cuihuir/Tiny-M/BOM/BOM.md

**[中文版 / Chinese](BOM_cn.md)**

# Tiny-M Replica BOM

> Based on XiaoChen DIY V2.2, combined with gsl12's original design. Personal replica & optimization version.
>
> Changelog: Based on XiaoChen DIY V2.2, differences from the original are noted.

---

## 1. Aluminum Extrusion

| ID | JLC Model | Spec | Qty | Processing | Notes |
|----|---|---|-----|---|---|
| 300-1 | TXCJ-H7-2020D-L300-SC-DA-LC-Z5-A10-RC-Z5-A60 | 300mm | 2 | Milled face, both-end M5 tap, left M5 hole @10mm, right M5 hole @60mm | Rear pillars |
| 300-2 | TXCJ-H7-2020D-L300-SC-DA-LC-Z5-A10-RC-Z5-A60-RE-Z5-A60 | 300mm | 2 | Milled face, both-end M5 tap, left M5 hole @10mm, right M5 hole @60mm + vertical M5 hole @60mm | Front pillars |
| 250 | TXCJ-H7-2020D-L250-DA-LC-Z5-A10-RC-Z5-A10 | 250mm | 2 | Both-end M5 tap, left M5 hole @10mm, right M5 hole @10mm | Z-axis |
| 260-1 | TXCJ-H7-2020D-L260-DA | 260mm | 2 | Both-end M5 tap | Top left/right |
| 260-2 | TXCJ-H7-2020D-L260-SC-DA-LC-Z5-A36 | 260mm | 2 | Milled face, both-end M5 tap, left M5 hole @36mm | Middle left/right |
| 260-3 | TXCJ-H7-2020D-L260-SC-DA-LC-Z5-A36 | 260mm | 2 | Milled face, both-end M5 tap, left M5 hole @36mm | Bottom left/right |
| 260-4 | TXCJ-H7-2020D-L260-SC-DA | 260mm | 3 | Milled face, both-end M5 tap | Horizontal cross |
| 260-5 | TXCJ-H7-2020D-L260-DA | 260mm | 1 | Both-end M5 tap | X-axis |
| 130-1 | TXCJ-H7-2020D-L130-SC-DA-LC-Z5-A40-RC-Z5-A40 | 130mm | 1 | Milled face, both-end M5 tap, left M5 hole @40mm, right M5 hole @40mm | Heatbed |
| 130-2 | TXCJ-H7-2020D-L130-LA | 130mm | 2 | Left-end M5 tap | Heatbed |

> JLC order file: `BOM/BOM-Frame-JLCFA.xlsx`

## 2. Linear Rails & Carriages

| Item | Spec | Qty | Notes |
|---|---|-----|---|
| MGN9 Rail | 200mm | 2 | Y-axis |
| MGN12 Rail | 200mm | 3 | X-axis x1, Z-axis x2 |
| MGN9H Carriage | - | 2 | Y-axis |
| MGN12H Carriage | **Extended (加长)** | 3 | X-axis x1, Z-axis x2. Must use extended version for E3D V6 hotend mount |

> **Important**: MGN12H carriages must be the **extended/longer version** (加长滑块). Standard MGN12H will not fit the E3D V6 hotend mount. See XiaoChen DIY README: "修改版已适配加长滑块".

### Rail Assembly Jigs (printed)

| File | Purpose |
|---|---|
| `STLs/rail-jigs/mgn12定位件.STL` | MGN12 rail positioning jig |
| `STLs/rail-jigs/mgn9定位件.STL` | MGN9 rail positioning jig |
| `STLs/rail-jigs/导轨滑块防滑脱固定件.stl` | Carriage anti-drop bracket |

## 3. Hotend & Extruder

| Item | Spec | Qty | Notes |
|---|---|-----|---|
| E3D V6 Bowden Hotend | - | 1 | |
| 4010 Blower Fan | - | 2 | |
| 4020 Cooling Fan | - | 1 | |
| BMG Dual Gear Extruder | - | 1 | |
| GT2 Belt | 6mm width | 4m | |

## 4. Endstops

| Item | Spec | Qty | Notes |
|---|---|-----|---|
| XY Mechanical Endstop | - | 2 | |
| Z Optical Endstop | - | 1 | XiaoChen DIY mod |

## 5. Stepper Motors

| Item | Spec | Qty | Notes |
|---|---|-----|---|
| XY Motor | 42x47 NEMA 17 | 2 | |
| Z Motor | NEMA 17 | 1 | |
| Extruder Motor | NEMA 17 | 1 | |
| GT2 20T Pulley | 5mm bore | 3 | Mounted on motors |
| AB Motor Pulley Spacer | ID5 OD10 H9 | 2 | Metal part or printed |

## 6. Heatbed

| Item | Spec | Qty | Notes |
|---|---|-----|---|
| T8 Lead Screw | 220mm | 1 | |
| Spider Coupler | OD25 H30 5-to-8 | 1 | Or standard 5-to-8 coupler |
| T8 Anti-backlash Nut | POM, no flange ridge | 1 | |
| Custom Aluminum Plate | 150x150x8mm | 1 | DXF: `DXFs/heatbed-aluminum-plate-v1.1.DXF`. Countersunk holes depth 2–3.5mm. Source: XiaoChen DIY V1.1 |
| Magnetic PEI Steel Sheet | 150x150mm | 1 | |
| Silicone Heater Pad | 220V 110W | 1 | |
| Solid State Relay | DC-AC | 1 | |
| Thermal Fuse | RH 250V 15A 125C | 1 | |
| Drag Chain | 10x10 bridge type | 1m | Open or closed |
| Leveling Spring | OD10 H25 | 3 | |
| Flat Head M3x30 Screw | - | 3 | Paired with springs & thumbscrews |
| Thumbscrew Nut | - | 3 | |

## 7. Electronics

| Item | Spec | Qty | Notes |
|---|---|-----|---|
| Controller Board | MKS Robin E3D | 1 | |
| SBC | Orange Pi Zero2 | 1 | |
| SD Card | 16GB | 1 | |
| SD Card Reader | - | 1 | |
| LCD Display | Mini 12864 | 1 | |
| Stepper Driver | TMC2209 | 4 | |
| Power Supply | 24V 250W | 1 | |
| Buck Converter | 24V to 5V | 1 | For Orange Pi |
| Rocker Switch | With power | 1 | |
| Power-off Relay | 1-ch 5V optocoupled | 1 | |

## 8. Screws Summary

| Type | Qty | Notes |
|---|-----|---|
| SHCS M2x12 | 5 | |
| SHCS M3x8 | 81 | |
| SHCS M3x10 | 13 | |
| SHCS M3x12 | 8 | |
| SHCS M3x16 | 1 | |
| SHCS M3x20 | 4 | |
| SHCS M3x25 | 4 | |
| SHCS M3x30 | 6 | |
| SHCS M3x35 | 16 | |
| SHCS M3x45 | 2 | |
| SHCS M3x50 | 2 | |
| SHCS M5x8 | 6 | |
| SHCS M5x10 | 8 | |
| SHCS M5x14 | 2 | |
| SHCS M5x16 | 2 | |
| SHCS M5x40 | 4 | |
| BHCS M3x6 | 1 | Direct drive only |
| BHCS M3x8 | 4 | |
| BHCS M3x12 | 1 | Direct drive only |
| BHCS M3x14 | 2 | Direct drive only |
| BHCS M3x20 | 2 | |
| BHCS M3x25 | 1 | Direct drive only |
| BHCS M5x6 | 4 | |
| BHCS M5x8 | 5 | |
| BHCS M5x10 | 35 | |
| BHCS M5x12 | 2 | |
| BHCS M5x14 | 6 | |
| BHCS M5x16 | 2 | |
| BHCS M5x20 | 1 | |
| BHCS M5x30 | 4 | |
| BHCS M5x35 | 4 | |

## 9. Nuts Summary

| Type | Qty | Notes |
|---|-----|---|
| M3 Spring Nut | 25 | |
| M3 Sliding Nut | 37 | Prepare 28 more for rails |
| M3x4x5 Heatset Insert | 22 | |
| M3 Hex Nut | 15 | |
| M5 Spring Nut | 16 | |
| M5 Sliding Nut | 31 | |

## 10. Bearings & Washers

| Type | Qty | Notes |
|---|-----|---|
| F695-2RS Flange Bearing (5mm) | 20 | |
| GT2 20T Toothed Idler (6mm belt) | 2 | |
| Washer 5x10x1mm | 22 | |
| Washer 5x10x0.5mm | 2 | |

## 11. Misc

| Item | Spec | Qty | Notes |
|---|---|-----|---|
| Rubber Feet | H12, OD18 | 4 | |
| Voron 0/0.1 Belt Clip | Rectangle | 2 | |
