cuihuir/Tiny-M/BOM/BOM_cn.md

**[English](BOM.md)**

# Tiny-M 复刻版 BOM

> 基于小辰DIY V2.2 版本，结合 gsl12 原版方案，个人复刻优化版
>
> 修改记录：以小辰DIY V2.2 为基础，标注与原版的差异

---

## 1. 型材

| 编号 | JLC 型号 | 规格 | 数量 | 加工内容 | 备注 |
|---|---|---|---|---|---|
| 300-1 | TXCJ-H7-2020D-L300-SC-DA-LC-Z5-A10-RC-Z5-A60 | 300mm | 2 | 铣端面、双端攻牙M5、左端水平沉头M5@10mm、右端水平沉头M5@60mm | 后立柱 |
| 300-2 | TXCJ-H7-2020D-L300-SC-DA-LC-Z5-A10-RC-Z5-A60-RE-Z5-A60 | 300mm | 2 | 铣端面、双端攻牙M5、左端水平沉头M5@10mm、右端水平+垂直沉头M5@60mm | 前立柱 |
| 250 | TXCJ-H7-2020D-L250-DA-LC-Z5-A10-RC-Z5-A10 | 250mm | 2 | 双端攻牙M5、左端水平沉头M5@10mm、右端水平沉头M5@10mm | Z 轴 |
| 260-1 | TXCJ-H7-2020D-L260-DA | 260mm | 2 | 双端攻牙M5 | 上方左右 |
| 260-2 | TXCJ-H7-2020D-L260-SC-DA-LC-Z5-A36 | 260mm | 2 | 铣端面、双端攻牙M5、左端水平沉头M5@36mm | 中间左右 |
| 260-3 | TXCJ-H7-2020D-L260-SC-DA-LC-Z5-A36 | 260mm | 2 | 铣端面、双端攻牙M5、左端水平沉头M5@36mm | 下方左右 |
| 260-4 | TXCJ-H7-2020D-L260-SC-DA | 260mm | 3 | 铣端面、双端攻牙M5 | 中间横 |
| 260-5 | TXCJ-H7-2020D-L260-DA | 260mm | 1 | 双端攻牙M5 | X 轴 |
| 130-1 | TXCJ-H7-2020D-L130-SC-DA-LC-Z5-A40-RC-Z5-A40 | 130mm | 1 | 铣端面、双端攻牙M5、左端水平沉头M5@40mm、右端水平沉头M5@40mm | 热床 |
| 130-2 | TXCJ-H7-2020D-L130-LA | 130mm | 2 | 左端攻牙M5 | 热床 |

> 嘉立创下单文件：`BOM/BOM-Frame-JLCFA.xlsx`

## 2. 导轨与滑块

| 名称 | 规格 | 数量 | 备注 |
|---|---|---|---|
| MGN9 导轨 | 200mm | 2 | Y 方向 |
| MGN12 导轨 | 200mm | 3 | X×1、Z×2 |
| MGN9H 滑块 | - | 2 | Y 方向 |
| MGN12H 滑块 | **加长版** | 3 | X×1、Z×2。必须使用加长滑块，标准滑块无法适配 E3D V6 热端固定座 |

> **重要**：MGN12H 滑块必须是**加长版本**。标准 MGN12H 无法安装 E3D V6 热端固定座。参考小辰DIY说明："修改版已适配加长滑块"。

### 导轨辅助打印件

| 文件 | 用途 |
|---|---|
| `STLs/rail-jigs/mgn12定位件.STL` | MGN12 导轨定位件 |
| `STLs/rail-jigs/mgn9定位件.STL` | MGN9 导轨定位件 |
| `STLs/rail-jigs/导轨滑块防滑脱固定件.stl` | 滑块防滑脱固定件 |

## 3. 热端与挤出

| 名称 | 规格 | 数量 | 备注 |
|---|---|---|---|
| E3D V6 远程挤出头 | - | 1 | |
| 4010 涡轮风扇 | - | 2 | |
| 4020 散热风扇 | - | 1 | |
| BMG 双齿轮减速挤出机 | - | 1 | |
| 2GT 同步带 | 6mm 宽 | 4m | |

## 4. 限位开关

| 名称 | 规格 | 数量 | 备注 |
|---|---|---|---|
| XY 机械限位开关 | - | 2 | |
| Z 光电限位 | - | 1 | 小辰DIY 修改方案 |

## 5. 电机

| 名称 | 规格 | 数量 | 备注 |
|---|---|---|---|
| XY 步进电机 | 42×47 NEMA 17 | 2 | |
| Z 步进电机 | NEMA 17 | 1 | |
| 挤出机电机 | NEMA 17 | 1 | |
| 2GT 20 齿同步轮 | 5mm 孔径 | 3 | 固定在电机上 |
| AB 电机同步轮格挡柱 | 内5 外10 高9 | 2 | 金属件或打印替代 |

## 6. 热床

| 名称 | 规格 | 数量 | 备注 |
|---|---|---|---|
| T8 丝杆 | 220mm | 1 | |
| 梅花联轴器 | 外25 高30 内5转8 | 1 | 或普通 5 转 8 |
| T8 消隙螺母 | POM 法兰盘无凸环 | 1 | |
| 定制铝板 | 150×150×8mm | 1 | 加工图：`DXFs/heatbed-aluminum-plate-v1.1.DXF`，沉头孔深度 2–3.5mm，来源：小辰DIY V1.1 |
| 磁性 PEI 钢板 | 150×150mm | 1 | |
| 硅胶加热垫 | 220V 110W | 1 | |
| 固态继电器 | DC-AC | 1 | |
| 热熔保险丝 | RH 250V 15A 125° | 1 | |
| 拖链 | 10×10 桥式 | 1m | 不开或外开均可 |
| 调节弹簧 | 外径10 高25 | 3 | |
| 平头 M3×30 螺丝 | - | 3 | 与弹簧手拧螺母配套 |
| 手拧螺母 | - | 3 | |

## 7. 电气

| 名称 | 规格 | 数量 | 备注 |
|---|---|---|---|
| 主板 | MKS Robin E3D | 1 | |
| 上位机 | 香橙派 Zero2 | 1 | |
| SD 卡 | 16G | 1 | |
| SD 卡读卡器 | - | 1 | |
| LCD 屏幕 | Mini 12864 | 1 | |
| 步进电机驱动 | TMC2209 | 4 | |
| 电源 | 24V 250W | 1 | |
| 降压模块 | 24V→5V | 1 | 给香橙派供电 |
| 电源船型开关 | - | 1 | 带电源 |
| 打完关机继电器 | 一路 5V 光电耦合 | 1 | |

## 8. 螺丝汇总

| 型号 | 数量 | 备注 |
|---|---|---|
| 杯头 M2×12 | 5 | |
| 杯头 M3×8 | 81 | |
| 杯头 M3×10 | 13 | |
| 杯头 M3×12 | 8 | |
| 杯头 M3×16 | 1 | |
| 杯头 M3×20 | 4 | |
| 杯头 M3×25 | 4 | |
| 杯头 M3×30 | 6 | |
| 杯头 M3×35 | 16 | |
| 杯头 M3×45 | 2 | |
| 杯头 M3×50 | 2 | |
| 杯头 M5×8 | 6 | |
| 杯头 M5×10 | 8 | |
| 杯头 M5×14 | 2 | |
| 杯头 M5×16 | 2 | |
| 杯头 M5×40 | 4 | |
| 半圆头 M3×6 | 1 | 近程挤出 |
| 半圆头 M3×8 | 4 | |
| 半圆头 M3×12 | 1 | 近程挤出 |
| 半圆头 M3×14 | 2 | 近程挤出 |
| 半圆头 M3×20 | 2 | |
| 半圆头 M3×25 | 1 | 近程挤出 |
| 半圆头 M5×6 | 4 | |
| 半圆头 M5×8 | 5 | |
| 半圆头 M5×10 | 35 | |
| 半圆头 M5×12 | 2 | |
| 半圆头 M5×14 | 6 | |
| 半圆头 M5×16 | 2 | |
| 半圆头 M5×20 | 1 | |
| 半圆头 M5×30 | 4 | |
| 半圆头 M5×35 | 4 | |

## 9. 螺母汇总

| 型号 | 数量 | 备注 |
|---|---|---|
| M3 弹珠螺母 | 25 | |
| M3 滑块螺母 | 37 | 额外准备 28 个用于导轨 |
| 热熔螺母 M3×4×5 | 22 | |
| M3 六角螺母 | 15 | |
| M5 弹珠螺母 | 16 | |
| M5 滑块螺母 | 31 | |

## 10. 轴承与垫片

| 型号 | 数量 | 备注 |
|---|---|---|
| F695-2RS 法兰轴承 (5mm) | 20 | |
| 2GT 20 齿惰轮（带宽 6mm） | 2 | |
| 垫片 5×10×1mm | 22 | |
| 垫片 5×10×0.5mm | 2 | |

## 11. 其他

| 名称 | 规格 | 数量 | 备注 |
|---|---|---|---|
| 脚垫 | 高12 大头直径18 | 4 | |
| Voron 0/0.1 同步带固定长方形 | - | 2 | |
