cuihuir/Tiny-M/BOM/BOM-Frame-JLCFA.md

# 嘉立创FA BOM - Frame (首版已下单)

> 来源：jialichuangtrs.xlsx，JLC 可直接下单型号

| 序号 | *我的型号 | 我的商品名称 | JLC型号（如有，则请填写） | *商品数量 | 是否国产替代 | 品牌 | 类别 | PO号 |
|---|---|---|---|---|---|---|---|---|
| 1 | 300-1 | 2020铝型材 300mm 后立柱 | TXCJ-H7-2020D-L300-SC-DA-LC-Z5-A10-RC-Z5-A60 | 2 | 是 | TXCJ | 铝型材 | |
| 2 | 300-2 | 2020铝型材 300mm 前立柱 | TXCJ-H7-2020D-L300-SC-DA-LC-Z5-A10-RC-Z5-A60-RE-Z5-A60 | 2 | 是 | TXCJ | 铝型材 | |
| 3 | 250 | 2020铝型材 250mm Z轴 | TXCJ-H7-2020D-L250-DA-LC-Z5-A10-RC-Z5-A10 | 2 | 是 | TXCJ | 铝型材 | |
| 4 | 260-1 | 2020铝型材 260mm 上方左右 | TXCJ-H7-2020D-L260-DA | 2 | 是 | TXCJ | 铝型材 | |
| 5 | 260-2 | 2020铝型材 260mm 中间左右 | TXCJ-H7-2020D-L260-SC-DA-LC-Z5-A36 | 2 | 是 | TXCJ | 铝型材 | |
| 6 | 260-3 | 2020铝型材 260mm 下方左右 | TXCJ-H7-2020D-L260-SC-DA-LC-Z5-A36 | 2 | 是 | TXCJ | 铝型材 | |
| 7 | 260-4 | 2020铝型材 260mm 中间横 | TXCJ-H7-2020D-L260-SC-DA | 3 | 是 | TXCJ | 铝型材 | |
| 8 | 260-5 | 2020铝型材 260mm X轴 | TXCJ-H7-2020D-L260-DA | 1 | 是 | TXCJ | 铝型材 | |
| 9 | 130-1 | 2020铝型材 130mm 热床(打孔40) | TXCJ-H7-2020D-L130-SC-DA-LC-Z5-A40-RC-Z5-A40 | 1 | 是 | TXCJ | 铝型材 | |
| 10 | 130-2 | 2020铝型材 130mm 热床 | TXCJ-H7-2020D-L130-LA | 2 | 是 | TXCJ | 铝型材 | |
