cuihuir/Tiny-M/BOM/reference/DRAFT-BOM-gsl12.md

**[中文版 / Chinese](DRAFT-BOM-gsl12_cn.md)**

# Tiny-M Draft BOM (gsl12 Original)

> Source: [gsl12/Tiny-M](https://github.com/gsl12/Tiny-M) original repository
>
> Status: DRAFT, published by original author gsl12

---

## Hardware

| Component | Standard | Qty | Notes |
|---|---|-----|---|
| 5x10x0.5 Shim Ring | DIN 988 5x10x0.5 | 17 | |
| 5x10x1 Shim Ring | DIN 988 5x10x1 | 6 | |
| 5x30mm Shaft | shaft 5x30mm | 1 | |
| M2.5x12 SHCS (dragon hotend only) | DIN 912 M2.5x12 | 4 | |
| M2x10 Self Tapping Screw for Plastic | - | 15 | |
| M3 T-Nut | M3 T-Nut | 6 | |
| M3 Brass Heatstake Inserts | M3x5.0x4.0 | 15 | |
| M3 Nut | DIN 934 M3 Nut | 14 | |
| M3x10 SHCS | DIN 912 M3x10 | 2 | |
| M3x12 SHCS | DIN 912 M3x12 | 2 | |
| M3x20 SHCS | DIN 912 M3x20 | 2 | |
| M3x25 SHCS | DIN 912 M3x25 | 2 | |
| M3x30 SHCS | DIN 912 M3x30 | 8 | |
| M3x35 SHCS | DIN 912 M3x35 | 8 | |
| M3x40 SHCS | DIN 912 M3x40 | 12 | |
| M3x50 SHCS | DIN 912 M3x50 | 4 | |
| M3x8 SHCS | DIN 912 M3x8 | 99 | |
| M4x8 SHCS | DIN 912 M4x8 | 4 | |
| M5 T-Nut | M5 T-Nut | 18 | |
| M5x10 BHCS | ISO 7380-1 M5x10 | 19 | |
| M5x15 BHCS | ISO 7380-1 M5x15 | 1 | |
| M5x16 BHCS | ISO 7380-1 M5x16 | 4 | |
| M5x20 BHCS | ISO 7380-1 M5x20 | 1 | |
| M5x30 BHCS | ISO 7380-1 M5x30 | 4 | |
| M5x35 BHCS | ISO 7380-1 M5x35 | 4 | |
| M5x40 SHCS | DIN 912 M5x40 | 4 | |

## Frame

| Component | Standard | Qty | Notes |
|---|---|-----|---|
| Frame 2020 Typ I 5mm | 300mm | 4 | |
| Frame 2020 Typ I 5mm | 260mm | 10 | |
| Frame 2020 Typ I 5mm | 250mm | 2 | |
| Frame 2020 Typ I 5mm | 130mm | 3 | |

## Electronic

| Component | Standard | Qty | Notes |
|---|---|-----|---|
| Nema 17 Motor 17HS19-2004S | 17HS19-2004S | 3 | XY + Z |
| Omron Mouse Button - Micro Switch | D2F-5L | 4 | |
| TL Dragon Hotend | - | 1 | |
| V6 Hotend 24V | V6 Hotend | 1 | |
| 4010 Blower Fan | 40x40x10 Blower Fan v1 | 4 | |
| 4020 DC Fan 24V | 40x40x20 DC Fan | 2 | |
| Mean Well LRS-150-24 | LRS-150-24 | 1 | Main electronics power |
| Mean Well LRS-350-24V | LRS-350-24V | 1 | For 24V heated bed; otherwise use 110V/220V heated bed |
| Raspberry Pi 4 | 2GB or 4GB | 1 | Pi 3 also works |
| DC-DC 5V 3A Converter | - | 1 | |
| SKR E3 Mini | Bigtreetech SKR E3 Mini | 1 | |
| Fysetc Mini 12864 | LCD Display | 1 | |

## Motion

| Component | Standard | Qty | Notes |
|---|---|-----|---|
| GT2 20T Pulley 6mm, 5mm Bore | Powdge GT2 20T Pulley 6mm | 3 | |
| F695-2RS Bearing | F695-2RS | 20 | |
| 2GT-20T Idler | 2GT-20T-idler | 2 | |
| MGN9 200mm Linear Rail | MGN9 200mm | 3 | |
| MGN12 200mm Linear Rail | MGN12 200mm | 2 | |
| TR8x8 Lead Screw | TR8x8 215mm | 1 | |
| 5x8 Flexible Spider Coupler | Stepper Coupler D25L30 | 1 | |
| Nema 17 Damper | - | 1 | |

## Buildplate

| Component | Standard | Qty | Notes |
|---|---|-----|---|
| MIC6 6mm Plate | 150x150mm | 1 | |
| Silicone AC Heater | 120V/240V 100x100mm 100W | 1 | |
| PEI + 3M 468P (200MP) | - | 1 | |
| Yellow Die Springs | 8x4x20mm | 3 | |
| Spring Steel Flex Buildplate | 150x150mm | 1 | OPTIONAL |

## Extruder

| Component | Standard | Qty | Notes |
|---|---|-----|---|
| Nema 17 Motor | 17HS08-1004S | 1 | Extruder motor |
| BMG Kit | - | 1 | |
| PTFE Tube | 1m | 2 | |

## Miscellaneous

| Component | Standard | Qty | Notes |
|---|---|-----|---|
| Rubber Feet | 21x12 | 4 | |
| Side Panels | - | 2 | |
| Bottom Panel | - | 1 | |
| Back Panel | - | 1 | |
