cuihuir/Tiny-M/BOM/reference/DRAFT-BOM-gsl12_cn.md

**[English](DRAFT-BOM-gsl12.md)**

# Tiny-M Draft BOM (gsl12 原版)

> 来源：[gsl12/Tiny-M](https://github.com/gsl12/Tiny-M) 原始仓库
>
> 状态：DRAFT，原作者 gsl12 发布

---

## 五金件

| 组件 | 标准 | 数量 | 备注 |
|---|---|---|---|
| 5x10x0.5 调整垫片 | DIN 988 5x10x0.5 | 17 | |
| 5x10x1 调整垫片 | DIN 988 5x10x1 | 6 | |
| 5x30mm 轴 | shaft 5x30mm | 1 | |
| M2.5x12 杯头螺丝（仅 Dragon 热端） | DIN 912 M2.5x12 | 4 | |
| M2x10 自攻螺丝（塑料用） | - | 15 | |
| M3 T型螺母 | M3 T-Nut | 6 | |
| M3 铜热熔螺母 | M3x5.0x4.0 | 15 | |
| M3 六角螺母 | DIN 934 M3 Nut | 14 | |
| M3x10 杯头螺丝 | DIN 912 M3x10 | 2 | |
| M3x12 杯头螺丝 | DIN 912 M3x12 | 2 | |
| M3x20 杯头螺丝 | DIN 912 M3x20 | 2 | |
| M3x25 杯头螺丝 | DIN 912 M3x25 | 2 | |
| M3x30 杯头螺丝 | DIN 912 M3x30 | 8 | |
| M3x35 杯头螺丝 | DIN 912 M3x35 | 8 | |
| M3x40 杯头螺丝 | DIN 912 M3x40 | 12 | |
| M3x50 杯头螺丝 | DIN 912 M3x50 | 4 | |
| M3x8 杯头螺丝 | DIN 912 M3x8 | 99 | |
| M4x8 杯头螺丝 | DIN 912 M4x8 | 4 | |
| M5 T型螺母 | M5 T-Nut | 18 | |
| M5x10 半圆头螺丝 | ISO 7380-1 M5x10 | 19 | |
| M5x15 半圆头螺丝 | ISO 7380-1 M5x15 | 1 | |
| M5x16 半圆头螺丝 | ISO 7380-1 M5x16 | 4 | |
| M5x20 半圆头螺丝 | ISO 7380-1 M5x20 | 1 | |
| M5x30 半圆头螺丝 | ISO 7380-1 M5x30 | 4 | |
| M5x35 半圆头螺丝 | ISO 7380-1 M5x35 | 4 | |
| M5x40 杯头螺丝 | DIN 912 M5x40 | 4 | |

## 框架型材

| 组件 | 标准 | 数量 | 备注 |
|---|---|---|---|
| 2020 铝型材 I 型 5mm | 300mm | 4 | |
| 2020 铝型材 I 型 5mm | 260mm | 10 | |
| 2020 铝型材 I 型 5mm | 250mm | 2 | |
| 2020 铝型材 I 型 5mm | 130mm | 3 | |

## 电子件

| 组件 | 标准 | 数量 | 备注 |
|---|---|---|---|
| Nema 17 电机 17HS19-2004S | 17HS19-2004S | 3 | XY + Z |
| 欧姆龙微动开关 | D2F-5L | 4 | |
| TL Dragon 热端 | - | 1 | |
| V6 热端 24V | V6 Hotend | 1 | |
| 4010 涡轮风扇 | 40x40x10 Blower Fan v1 | 4 | |
| 4020 直流风扇 24V | 40x40x20 DC Fan | 2 | |
| 明纬 LRS-150-24 电源 | LRS-150-24 | 1 | 主电子件供电 |
| 明纬 LRS-350-24V 电源 | LRS-350-24V | 1 | 24V 热床需要；否则使用 110V/220V 热床 |
| 树莓派 4 | 2GB 或 4GB | 1 | 树莓派 3 也可以 |
| DC-DC 5V 3A 降压模块 | - | 1 | |
| SKR E3 Mini 主板 | Bigtreetech SKR E3 Mini | 1 | |
| Fysetc Mini 12864 屏幕 | LCD Display | 1 | |

## 运动部件

| 组件 | 标准 | 数量 | 备注 |
|---|---|---|---|
| GT2 20T 同步轮 6mm 5mm孔径 | Powdge GT2 20T Pulley 6mm | 3 | |
| F695-2RS 轴承 | F695-2RS | 20 | |
| 2GT-20T 齿形惰轮 | 2GT-20T-idler | 2 | |
| MGN9 200mm 导轨 | MGN9 200mm | 3 | |
| MGN12 200mm 导轨 | MGN12 200mm | 2 | |
| TR8x8 丝杆 | TR8x8 215mm | 1 | |
| 5x8 梅花联轴器 | Stepper Coupler D25L30 | 1 | |
| Nema 17 减震垫 | - | 1 | |

## 热床

| 组件 | 标准 | 数量 | 备注 |
|---|---|---|---|
| MIC6 6mm 铝板 | 150x150mm | 1 | |
| 硅胶交流加热垫 | 120V/240V 100x100mm 100W | 1 | |
| PEI + 3M 468P (200MP) | - | 1 | |
| 黄色压簧 | 8x4x20mm | 3 | |
| 弹簧钢柔性热床板 | 150x150mm | 1 | 可选 |

## 挤出机

| 组件 | 标准 | 数量 | 备注 |
|---|---|---|---|
| Nema 17 电机 | 17HS08-1004S | 1 | 挤出机电机 |
| BMG 套件 | - | 1 | |
| PTFE 管材 | 1m | 2 | |

## 其他

| 组件 | 标准 | 数量 | 备注 |
|---|---|---|---|
| 橡胶脚垫 | 21x12 | 4 | |
| 侧面板 | - | 2 | |
| 底面板 | - | 1 | |
| 背面板 | - | 1 | |
