cuihuir/Tiny-M/BOM/reference/XiaoChen-DIY-BOM-v2.2_cn.md

**[English](XiaoChen-DIY-BOM-v2.2.md)**

# Tiny-M BOM (基于小辰DIY V2.2)

> 基础 BOM 来源：[小辰DIY (pangqc/voron-tiny-m)](https://gitee.com/pangqc/voron-tiny-m) V2.2 版本
>
> 教程视频：https://www.bilibili.com/video/BV1b94y1m7Kd/

---

## 1. 硬件采购清单

### 型材

| 名称 | 规格 | 数量 | 备注 |
|---|---|---|---|
| 2020 铝型材 | 300mm | 4 | 四根立柱 |
| 2020 铝型材 | 260mm | 10 | 上方左右两侧×2、中间左右两侧×2、下方左右两侧×2、中间横着×3、X轴×1 |
| 2020 铝型材 | 250mm | 2 | 两根 Z 轴 |
| 2020 铝型材 | 130mm | 3 | 热床三根 |

### 导轨与滑块

| 名称 | 规格 | 数量 | 备注 |
|---|---|---|---|
| MGN9 导轨 | 200mm | 2 | Y 方向 |
| MGN12 导轨 | 200mm | 3 | X 方向×1、Z 方向×2 |
| MGN9H 滑块 | - | 2 | Y 方向 |
| MGN12H 滑块 | - | 3 | X 方向×1、Z 方向×2 |

### 喷头（E3D 远程版本）

| 名称 | 规格 | 数量 | 备注 |
|---|---|---|---|
| E3D 远程挤出头 | - | 1 | |
| 4010 涡轮风扇 | - | 2 | |
| 4020 散热风扇 | - | 1 | |
| Voron 0/0.1 同步带固定长方形 | - | 2 | |

### 限位开关

| 名称 | 规格 | 数量 | 备注 |
|---|---|---|---|
| XY 限位开关 | 机械限位 | 2 | |
| Z 光电限位 | - | 1 | 小辰DIY 修改：替代原版机械限位 |

### 电机

| 名称 | 规格 | 数量 | 备注 |
|---|---|---|---|
| XY 方向电机 | 42×47 | 2 | |
| Z 方向电机 | NEMA 17 | 1 | |
| 挤出机电机 | NEMA 17 | 1 | |
| 2GT 20 齿同步轮 | - | 3 | 固定在电机上 |

### 热床

| 名称 | 规格 | 数量 | 备注 |
|---|---|---|---|
| T8 丝杆 | 220mm | 1 | |
| 梅花联轴器 | 外25 高30 内5转8 | 1 | 也可用普通 5 转 8 联轴器 |
| T8 消隙螺母 | POM 材质推荐 | 1 | 建议法兰盘不带凸环 |
| 定制铝板 | 150×150×8mm | 1 | |
| 磁性 PEI 钢板 | 150×150mm | 1 | |
| 硅胶加热垫 | 220V 110W | 1 | |
| 固态继电器 | DC-AC | 1 | |
| 热熔保险丝 | RH 250V 15A 125° | 1 | |
| 拖链 | 10×10 桥式 | 1 米 | 不开或外开均可 |
| 调节弹簧 | 外径10 高25 | 3 | |
| 平头 M3×30 螺丝 | - | 3 | 与弹簧、手拧螺母配套 |
| 手拧螺母 | - | 3 | |

### 电气

| 名称 | 规格 | 数量 | 备注 |
|---|---|---|---|
| 主板 | MKS Robin E3D | 1 | |
| 上位机 | 香橙派 Zero2 | 1 | |
| SD 卡 | 16G | 1 | |
| SD 卡读卡器 | - | 1 | |
| LCD 屏幕 | Mini 12864 | 1 | |
| 步进电机驱动 | TMC2209 | 4 | |
| 电源 | 24V 250W | 1 | |
| 降压模块 | 24V→5V | 1 | 给香橙派供电 |
| 电源船型开关 | 带电源 | 1 | |
| 继电器（打完关机） | 一路 5V 光电耦合继电器 | 1 | |

### 其他

| 名称 | 规格 | 数量 | 备注 |
|---|---|---|---|
| 脚垫 | 高12 大头直径18 | 4 | |
| AB 电机同步轮格挡柱 | 内5 外10 高9 | 2 | 也可打印 STL 替代 |
| BMG 双齿轮减速挤出机 | - | 1 | |
| 2GT 同步带 | 6mm 宽 | 4 米 | |

---

## 2. 螺丝螺母垫片轴承总表

### 螺丝汇总

| 型号 | 数量 | 备注 |
|---|---|---|
| 杯头 M2×12 | 5 | |
| 杯头 M3×8 | 81 | |
| 杯头 M3×10 | 13 | |
| 杯头 M3×12 | 8 | |
| 杯头 M3×16 | 1 | |
| 杯头 M3×20 | 4 | |
| 杯头 M3×25 | 4 | |
| 杯头 M3×30 | 6 | |
| 杯头 M3×35 | 16 | |
| 杯头 M3×45 | 2 | |
| 杯头 M3×50 | 2 | |
| 杯头 M5×8 | 6 | |
| 杯头 M5×10 | 8 | |
| 杯头 M5×14 | 2 | |
| 杯头 M5×16 | 2 | |
| 杯头 M5×40 | 4 | |
| 半圆头 M3×6 | 1 | 近程挤出用 |
| 半圆头 M3×8 | 4 | |
| 半圆头 M3×12 | 1 | 近程挤出用 |
| 半圆头 M3×14 | 2 | 近程挤出用 |
| 半圆头 M3×20 | 2 | |
| 半圆头 M3×25 | 1 | 近程挤出用 |
| 半圆头 M5×6 | 4 | |
| 半圆头 M5×8 | 5 | |
| 半圆头 M5×10 | 35 | |
| 半圆头 M5×12 | 2 | |
| 半圆头 M5×14 | 6 | |
| 半圆头 M5×16 | 2 | |
| 半圆头 M5×20 | 1 | |
| 半圆头 M5×30 | 4 | |
| 半圆头 M5×35 | 4 | |

### 螺母汇总

| 型号 | 数量 | 备注 |
|---|---|---|
| M3 弹珠螺母 | 25 | |
| M3 滑块螺母 | 37 | 建议额外准备 28 个用于导轨 |
| 热熔螺母 M3×4×5 | 22 | |
| M3 六角螺母 | 15 | |
| M5 弹珠螺母 | 16 | |
| M5 滑块螺母 | 31 | |

### 轴承汇总

| 型号 | 数量 | 备注 |
|---|---|---|
| F695-2RS 法兰轴承 (5mm) | 20 | |
| 2GT 20 齿惰轮（带宽 6mm） | 2 | |

### 垫片汇总

| 型号 | 数量 | 备注 |
|---|---|---|
| 5×10×1mm | 22 | |
| 5×10×0.5mm | 2 | |

---

## 3. 各部件螺丝螺母明细

### 导轨

| 部件 | 螺丝 | 数量 | 螺母 | 数量 | 备注 |
|---|---|---|---|---|---|
| MGN12 导轨（X 方向） | 杯头 M3×8 | 10 | M3 弹珠螺母 | 5 | 孔距 20，一根导轨 200mm，10 个螺丝 |
| | | | M3 滑块螺母 | 5 | |
| MGN9 导轨（Y 方向） | 杯头 M3×8 | 20 | M3 弹珠螺母 | 10 | |
| | | | M3 滑块螺母 | 10 | |
| MGN12 导轨（Z 方向） | 杯头 M3×8 | 20 | M3 弹珠螺母 | 10 | |
| | | | M3 滑块螺母 | 10 | |
| MGN12 滑块（X） | - | - | - | - | 螺丝在喷头处 |
| MGN9 滑块（Y） | - | - | - | - | 螺丝在龙门架处 |
| MGN12 滑块（Z） | - | - | - | - | 螺丝在热床连接架处 |

### 喷头（E3D 远程版本）

| 部件 | 螺丝 | 数量 | 螺母 | 数量 | 备注 |
|---|---|---|---|---|---|
| 连接 X 方向滑块 | 杯头 M3×8 | 4 | | | |
| 连接皮带紧固架 | 杯头 M3×45 | 2 | M3 六角螺母 | 2 | |
| 紧固皮带 | 半圆头 M3×8 | 2 | | | |
| 连接两侧架子（靠近导轨） | 杯头 M3×30 | 1 | M3 六角螺母 | 1 | |
| 贯穿两侧架子 | 杯头 M3×50 | 2 | M3 六角螺母 | 2 | |
| 连接 4020 散热风扇 | 半圆头 M3×20 | 2 | 热熔螺母 M3×4×5 | 1 | |
| X 限位开关 | 杯头 M2×12 | 1 | | | |

### 龙门架（Y 方向）

| 部件 | 螺丝 | 数量 | 螺母/垫片/轴承 | 数量 | 备注 |
|---|---|---|---|---|---|
| MGN9 滑块（Y） | 杯头 M3×8 | 8 | | | 左右各 4 |
| 连接 AB 同步轮 | 半圆头 M5×30 | 4 | 垫片 5×10×1 | 8 | 左右各 2 螺丝、各 4 垫片 |
| | | | 垫片 5×10×0.5 | 2 | 左右各 1 |
| | | | F695 轴承 | 4 | 左右各 2 |
| | | | 2GT 20 齿惰轮 | 2 | 左右各 1 |
| 连接龙门架 | 杯头 M3×20 | 2 | | | 左右各 1 |
| 连接龙门架 | 杯头 M2×12 | 2 | | | 左右各 1 |
| 连接 X 方向型材 | 半圆头 M5×8 | 5 | M5 滑块螺母 | 5 | 左 3 右 2 |
| 固定 X 轴限位挡片 | 半圆头 M5×20 | 1 | M5 滑块螺母 | 1 | 垫片 5×10×1 ×3 加高限位挡片 |

### AB 电机

| 部件 | 螺丝 | 数量 | 螺母/垫片/轴承 | 数量 | 备注 |
|---|---|---|---|---|---|
| 贯穿连接机架 | 杯头 M3×30 | 4 | M3 六角螺母 | 4 | 左右各 2 |
| 贯穿连接机架到型材 | 杯头 M3×35 | 8 | M3 滑块螺母 | 8 | 左右各 4 |
| 连接 AB 电机 | 杯头 M3×35 | 8 | | | 左右各 4 |
| 连接同步轮 | 半圆头 M5×35 | 2 | M5 滑块螺母 | 2 | 左右各 1 |
| | | | 垫片 5×10×1 | 4 | 左右各 2 |
| | | | F695 轴承 | 4 | 左右各 2 |
| 连接同步轮 | 杯头 M5×40 | 2 | 垫片 5×10×1 | 6 | 左右各 3 |
| | | | F695 轴承 | 8 | 左右各 4 |
| 连接 Y 限位开关 | 杯头 M2×12 | 2 | | | 在 B 电机架子上 |
| 连接上方左右侧型材 | 半圆头 M5×14 | 2 | | | 左右各 1 |

### 前方 AB 同步带

| 部件 | 螺丝 | 数量 | 螺母/垫片/轴承 | 数量 | 备注 |
|---|---|---|---|---|---|
| 连接左右上方型材 | 半圆头 M5×16 | 2 | | | 左右各 1 |
| 连接 AB 同步轮 | 杯头 M5×40 | 2 | 垫片 5×10×1 | 4 | 左右各 2 |
| | | | F695 轴承 | 4 | 左右各 2 |
| 连接左右机架 | 半圆头 M5×35 | 2 | M5 滑块螺母 | 2 | 左右各 1 |

### 热床

| 部件 | 螺丝 | 数量 | 螺母 | 数量 | 备注 |
|---|---|---|---|---|---|
| 连接滑块（左右各 2 上） | 杯头 M3×10 | 4 | | | |
| 连接滑块（左右各 2 下） | 杯头 M3×12 | 4 | | | |
| 连接型材（左右各 1） | 杯头 M3×10 | 2 | M3 滑块螺母 | 2 | |
| 连接型材（左右各 3） | 杯头 M5×10 | 6 | M5 滑块螺母 | 6 | |
| 前方 Tiny 标志架 | 杯头 M5×10 | 2 | M5 滑块螺母 | 2 | |
| | 杯头 M5×14 | 2 | | | |
| 三根型材连接 | 半圆头 M5×10 | 2 | | | 通过攻丝孔固定 |
| Z 电机座固定电机 | 杯头 M3×25 | 4 | | | |
| Z 电机座固定座 | 半圆头 M5×10 | 3 | M5 滑块螺母 | 3 | |
| 连接 T8 消隙螺母 | 杯头 M3×12 | 4 | M3 六角螺母 | 4 | |
| 热床丝杆连接件 | 杯头 M5×16 | 2 | M5 滑块螺母 | 2 | V1.3 版本后加 |
| 连接拖链一端 | 半圆头 M3×10 | 2 | M3 六角螺母 | 2 | V1.3 版本后加 |
| 底部型材定位架 | 杯头 M5×8 | 2 | M5 滑块螺母 | 2 | |
| 顶部型材定位架 | 杯头 M5×8 | 2 | M5 滑块螺母 | 2 | |

### Z 限位组装

| 部件 | 螺丝 | 数量 | 螺母 | 数量 | 备注 |
|---|---|---|---|---|---|
| 光电限位支架 | 半圆头 M5×10 | 2 | M5 弹珠螺母 | 2 | 连接到 Z 轴 250 型材 |
| 光电限位开关 | 半圆头 M3×8 | 2 | 热熔螺母 M3×4×5 | 2 | 连接到限位支架 |
| 热床左侧连接块 | | | 热熔螺母 M3×4×5 | 1 | |
| 调节高度螺丝 | 杯头 M3×20 | 1 | | | 拧在滚花螺母内，调节限位 |

### 连接型材架

| 部件 | 螺丝 | 数量 | 螺母 | 数量 | 备注 |
|---|---|---|---|---|---|
| 左右中间两侧 260 型材 | 半圆头 M5×10 | 2 | | | 每根 1 个 |
| 热床两根 250 型材 | 半圆头 M5×6 | 4 | M5 滑块螺母 | 4 | 每根 2 个 |
| 前方两根 300 立柱 | 半圆头 M5×10 | 6 | | | 每根 3 个 |
| 后方两根 300 立柱 | 半圆头 M5×10 | 4 | | | 每根 2 个 |
| 左右下方两侧 260 型材 | 半圆头 M5×10 | 2 | | | 每根 1 个 |
| 热床两根 130 型材 | 半圆头 M5×10 | 2 | | | 每根 1 个 |
| 连接拖链另一端 | 杯头 M3×8 | 2 | M3 滑块螺母 | 2 | |

### 脚垫

| 部件 | 螺丝 | 数量 | 备注 |
|---|---|---|---|
| 高12 大头直径20 | 半圆头 M5×14 | 4 | |

### 电气固定

| 部件 | 螺丝 | 数量 | 螺母 | 数量 | 备注 |
|---|---|---|---|---|---|
| 船型开关（固定在裙边） | 杯头 M5×8 | 2 | M5 弹珠螺母 | 2 | |
| 电源固定架（连接电源） | 杯头 M3×8 | 6 | | | |
| 电源固定架（连接底部） | 半圆头 M5×12 | 2 | M5 弹珠螺母 | 2 | |
| | 半圆头 M5×10 | 2 | M5 弹珠螺母 | 2 | |
| 香橙派 Zero2 固定架 | 半圆头 M5×10 | 2 | 热熔螺母 M3×4×5 | 4 | |
| | 杯头 M3×10 | 4 | | | 连接主板 |
| 继电器底座（打完关机） | 半圆头 M5×10 | 2 | M5 弹珠螺母 | 2 | |
| | 杯头 M3×8 | 4 | 热熔螺母 M3×4×5 | 4 | |
| 24V→5V 降压模块 | 半圆头 M5×10 | 2 | M5 弹珠螺母 | 2 | |
| | 杯头 M3×8 | 4 | 热熔螺母 M3×4×5 | 4 | |
| 固态继电器 | 半圆头 M5×10 | 2 | M5 弹珠螺母 | 2 | |
| | 杯头 M3×8 | 2 | 热熔螺母 M3×4×5 | 2 | |
| MKS Robin E3D 主板底座 | 半圆头 M5×10 | 2 | M5 弹珠螺母 | 2 | |
| | 杯头 M3×30 | 2 | | | 固定上方两个孔位 |
| | 杯头 M3×8 | 1 | | | 固定中间孔位 |
| | 杯头 M3×20 | 1 | | | 固定右下方孔位 |
| | 杯头 M3×10 | 3 | 热熔螺母 M3×4×5 | 4 | 固定散热风扇 |
| | 杯头 M3×16 | 1 | | | 固定散热风扇 |

### Sailfin 近程挤出头（追加）

| 部件 | 螺丝 | 数量 | 螺母 | 数量 | 备注 |
|---|---|---|---|---|---|
| 贯穿左右两边 | 杯头 M3×35 | 2 | 热熔螺母 M3×4×5 | 2 | |
| 贯穿左右两边（带皮带固定座） | 杯头 M3×35 | 2 | 热熔螺母 M3×4×5 | 2 | |
| 贯穿左右风扇固定 | 杯头 M3×35 | 2 | 热熔螺母 M3×4×5 | 2 | |
| 贯穿左右两边（靠近滑块） | 杯头 M3×35 | 1 | 热熔螺母 M3×4×5 | 1 | |
| 连接 X 方向滑块 | 杯头 M3×8 | 4 | 热熔螺母 M3×4×5 | 2 | |
| 固定线束 | 杯头 M3×8 | 2 | | | |
| 皮带固定座 | 半圆头 M3×8 | 2 | | | |
| 挤出机固定座 | 杯头 M3×10 | 2 | 热熔螺母 M3×4×5 | 2 | |
| 固定电机 | 半圆头 M3×14 | 2 | | | |
| 贯穿丝 | 半圆头 M3×25 | 1 | 热熔螺母 M3×4×5 | 1 | |
| 固定最前面 | 半圆头 M3×6 | 1 | 热熔螺母 M3×4×5 | 1 | |
| 压耗材丝旋钮 | | | 热熔螺母 M3×4×5 | 1 | |
| 后面压两层 | 半圆头 M3×12 | 1 | 热熔螺母 M3×4×5 | 1 | |
| X 限位开关 | 杯头 M2×12 | 1 | | | |

---

## 4. 型材开孔与攻丝

### 攻丝

| 型材 | 攻丝方位 | 攻丝规格 |
|---|---|---|
| 上方左右两侧 260 | 每根两头 | M5×10 |
| 四根 300 立柱 | 每根一头 | M5×10 |
| | 每根另一头 | M5×8 |
| 中间左右两侧 260 | 每根两头 | M5×10 |
| 下方左右两侧 260 | 每根两头 | M5×10 |
| 中间横着三根 260 | 每根两头 | M5×10 |
| 热床两根 130 | 每根两头 | M5×10 |
| Z 轴 250 | 无攻丝 | - |
| X 轴 260 | 无攻丝 | - |

### 打孔

| 型材 | 打孔方位 | 孔径 |
|---|---|---|
| 前方两根 300 立柱 | 一头距边 10mm 打孔 | M5 |
| | 另一头距边 60mm（横竖各打一次） | M5 |
| 后方两根 300 立柱 | 一头距边 10mm 打孔 | M5 |
| | 另一头距边 60mm（与一头同侧） | M5 |
| 下方左右两侧 260 | 一头距边 36mm 打孔 | M5 |
| 中间左右两侧 260 | 一头距边 36mm 打孔 | M5 |
| Z 轴 250 | 两头距边 10mm 打孔 | M5 |
| 热床第三根 130 | 两头距边 40mm 打孔 | M5 |

---

## 5. 组装预埋螺母与定位件

### 预埋螺母

| 螺母 | 数量 | 备注 |
|---|---|---|
| M5 滑块螺母 | 15 | |
| M3 滑块螺母 | 8 | 导轨螺母未计入，建议额外准备 28 个 |

### 组装定位件

| 名称 | 数量 | 备注 |
|---|---|---|
| Z 轴热床边 78.5 定位 | 2 | 辅助定位打印件 |
| Z 轴热床两根 250 定位 | 2 | 辅助定位打印件 |
| 后方两根立柱下方 260 定位 | 1 | 辅助定位打印件 |
| 前面两根立柱下方 260 定位 | 1 | 辅助定位打印件 |

---

## 6. 脚垫与导轨安装螺丝

| 项目 | 螺丝 | 数量 | 螺母 | 数量 | 备注 |
|---|---|---|---|---|---|
| 脚垫 | M5×14 半圆头 | 4 | | | |
| Z 轴两根导轨 | M3×8 杯头 | 16 | M3 滑块螺母 | 16 | |
| X 轴一根导轨 | M3×8 杯头 | 8 | M3 滑块螺母 | 8 | |
| Y 轴两根导轨 | M3×8 杯头 | 20 | | | 无需螺母，已预埋 |
