cuihuir/Tiny-M/BOM/reference/DRAFT - BOM - Tiny M.xlsx

Sheet: BOM_Tiny_M
Category | Component | Standard | Qty | Sourcing DE | AliExpress Source | Alternative Source | Notes
Hardware | 5x10x0.5 Shim Ring | DIN 988 5x10x0.5 Shim Ring | 17
Hardware | 5x10x1 Shim Ring | DIN 988 5x10x1 Shim Ring | 6
Hardware | 5x30mm | shaft 5x30mm | 1
Hardware | M2.5x12 SHCS (for dragon hotend only) | DIN 912 M2.5x12 | 4
Hardware | M2x10 self tapping screw for Plastic |  | 15
Hardware | M3 - T-Nut | M3 - T-Nut | 6
Hardware | M3 Brass Heatstake Inserts | M3x5.0x4.0 | 15
Hardware | M3 Nut | DIN 934 M3 Nut | 14
Hardware | M3x10 SHCS | DIN 912 M3x10 | 2
Hardware | M3x12 SHCS | DIN 912 M3x12 | 2
Hardware | M3x20 SHCS | DIN 912 M3x20 | 2
Hardware | M3x25 SHCS | DIN 912 M3x25 | 2
Hardware | M3x30 SHCS | DIN 912 M3x30 | 8
Hardware | M3x35 SHCS | DIN 912 M3x35 | 8
Hardware | M3x40 SHCS | DIN 912 M3x40 | 12
Hardware | M3x50 SHCS | DIN 912 M3x50 | 4
Hardware | M3x8 SHCS | DIN 912 M3x8 | 99
Hardware | M4x8 SHCS | DIN 912 M4x8 | 4
Hardware | M5 T-Nut | M5 T-Nut | 18
Hardware | M5x10 BHCS | ISO 7380-1 M5x10 | 19
Hardware | M5x15 BHCS | ISO 7380-1 M5x15 | 1
Hardware | M5x16 BHCS | ISO 7380-1 M5x16 | 4
Hardware | M5x20 BHCS | ISO 7380-1 M5x20 | 1
Hardware | M5x30 BHCS | ISO 7380-1 M5x30 | 4
Hardware | M5x35 BHCS | ISO 7380-1 M5x35 | 4
Hardware | M5x40 SHCS | DIN 912 M5x40 | 4
Frame | Frame 2020 Typ I 5mm | 300mm | 4 | MyAluProfil.de (https://www.myaluprofil.de/aluminiumprofil-20x20-nut-5-i-typ-.html)
Frame | Frame 2020 Typ I 5mm | 260mm | 10 | MyAluProfil.de (https://www.myaluprofil.de/aluminiumprofil-20x20-nut-5-i-typ-.html)
Frame | Frame 2020 Typ I 5mm | 250mm | 2 | MyAluProfil.de
Frame | Frame 2020 Typ I 5mm | 130mm | 3 | MyAluProfil.de
Electronic | Nema 17 Motor 17HS19-2004S | 17HS19-2004S | 3
Electronic | Omron Mouse Button - Micro Switch | D2F-5L | 4
Electronic | TL dragon hotend |  | 1
Electronic | V6 Hotend 24V | V6 Hotend | 1
Electronic | 4010 Blower Fan | 40x40x10 Blower Fan v1 | 4
Electronic | 4020 DC Fan 24V | 40x40x20 DC Fan | 2
Electronic | Mean Well LRS-150-24 | LRS-150-24 | 1 |  |  |  | Needed for the main electronis (board, motors, lcd, etc.)
Electronic | Mean Well LRS-350-24V | LRS-350-24V | 1 |  |  |  | Needed if you use a 24V heated bed. If not you must use a 110V/220V heated bed.
Electronic | Raspberry Pi 4 | 2GB or 4GB Version | 1 |  |  |  | If you have a Pi 3 you can use this also
Electronic | DC-DC 5V 3A converter |  | 1
Electronic | SKR E3 Mini | Bigtreetech SKR E3 Mini | 1
Electronic | Fysetc Mini 12864 | LCD Display | 1
Motion | GT2 20T Pulley 6mm, 5mm Bore | Powdge GT2 20T Pulley 6mm, 5mm Bore | 3
Motion | F695-2RS | F695-2RS bearing | 20
Motion | 2GT-20T-idler | 2GT-20T-idler | 2
Motion | MGN9-200mm | MGN9 200mm | 3
Motion | MGN12_200mm | linear rail MGN12 200mm | 2
Motion | TR8x8 Lead Screw Nut | lead screw TR8x8 215mm | 1
Motion | 5x8 flexible spider coupler | Stepper Coupler D25L30 | 1
Motion | Nema 17 Damper |  | 1
Buildplate | MIC6 6mm Plate - 150x150mm |  | 1
Buildplate | Silicone AC 120V/240V Heater 100x100mm 100W |  | 1
Buildplate | PEI + 3M 468P (200MP) |  | 1
Buildplate | yellow die springs 8x4x20mm |  | 3
Buildplate | Spring Steel Flex Buildplate 150x150mm (OPTIONAL)
Extruder | Nema 17 Motor 17HS19-2004S | 17HS08-1004S | 1
Extruder | BMG Kit |  | 1
Extruder | PFTE Tube 1m |  | 2
Mics. | Rubber Feed - 21x12 |  | 4 | Amazon.de (https://www.amazon.de/gp/product/B008LTY1NO/ref=ppx_yo_dt_b_asin_title_o00_s00?ie=UTF8&psc=1)
Mics. | Panels side |  | 2
Mics. | Panel bottom |  | 1
Mics. | panel back |  | 1

Sheet: Screw_Consolidated
Hardware | 5x10x0.5 Shim Ring | DIN 988 5x10x0.5 Shim Ring | 6 | x | Hardware | 5x10x0.5 Shim Ring | DIN 988 5x10x0.5 Shim Ring | 17
hardware | 5x10x0.5 Shim Ring | DIN 988 5x10x0.5 Shim Ring | 11 | x | Hardware | 5x10x1 Shim Ring | DIN 988 5x10x1 Shim Ring | 6
Hardware | 5x10x1 Shim Ring | DIN 988 5x10x1 Shim Ring | 1 | x | Hardware | 5x30mm | shaft 5x30mm | 1
Hardware | 5x10x1 Shim Ring | DIN 988 5x10x1 Shim Ring | 5 | x | Hardware | M2.5x12 SHCS (for dragon hotend only) | DIN 912 M2.5x12 | 4
Hardware | 5x30mm | shaft 5x30mm | 1 | x | Hardware | M2x10 self tapping screw for Plastic |  | 15
Hardware | DIN 912 M3x8 | DIN 912 M3x8 | 16 | x | Hardware | M3 - T-Nut | M3 - T-Nut | 6
Hardware | DIN 912 M3x8 | DIN 912 M3x8 | 72 | x | Hardware | M3 Brass Heatstake Inserts | M3x5.0x4.0 | 15
 | DIN 912 M3x8 | DIN 912 M3x8 | 6 | x | Hardware | M3 Nut | DIN 934 M3 Nut | 14
Hardware | heat insert M3x5.0x4.0 | heat set threaded insert | 4 | x | Hardware | M3x10 SHCS | DIN 912 M3x10 | 2
 | heat insert M3x5.0x4.0 | heat set threaded insert | 6 | x | Hardware | M3x12 SHCS | DIN 912 M3x12 | 2
Hardware | ISO 7380-1 M5x16 | ISO 7380-1 M5x16 | 1 | x | Hardware | M3x20 SHCS | DIN 912 M3x20 | 2
Hardware | ISO 7380-1 M5x16 | ISO 7380-1 M5x16 | 1 | x | Hardware | M3x25 SHCS | DIN 912 M3x25 | 2
Hardware | ISO 7380-1 M5x30 | ISO 7380-1 M5x30 | 4 | x | Hardware | M3x30 SHCS | DIN 912 M3x30 | 8
 | M2.5x12 SHCS (for dragon hotend only) |  | 4 | x | Hardware | M3x35 SHCS | DIN 912 M3x35 | 8
 | M2x10 self tapping screw |  | 2 | x | Hardware | M3x40 SHCS | DIN 912 M3x40 | 12
Hardware | M3 - T-Nut sym | M3 - T-Nut sym | 4 | x | Hardware | M3x50 SHCS | DIN 912 M3x50 | 4
 | M3 Heat Threaded Insert | M3 Threaded Insert | 5 | x | Hardware | M3x8 SHCS | DIN 912 M3x8 | 99
Hardware | M3 Nut | DIN 934 M3 Nut | 2 | x | Hardware | M4x8 SHCS | DIN 912 M4x8 | 4
Hardware | M3 Nut | DIN 934 M3 Nut | 12 | x | Hardware | M5 T-Nut | M5 T-Nut | 18
Hardware | M3-T-Nut | M3-T-Nut | 12 | x | Hardware | M5x10 BHCS | ISO 7380-1 M5x10 | 19
Hardware | M3-T-Nut | M3-T-Nut | 26 | x | Hardware | M5x15 BHCS | ISO 7380-1 M5x15 | 1
 | M3-T-Nut | M3-T-Nut | 4 | x | Hardware | M5x16 BHCS | ISO 7380-1 M5x16 | 4
Hardware | M3x10 | DIN 912 M3x10 | 2 | x | Hardware | M5x20 BHCS | ISO 7380-1 M5x20 | 1
Hardware | M3x12 | DIN 912 M3x12 | 2 | x | Hardware | M5x30 BHCS | ISO 7380-1 M5x30 | 4
Hardware | M3x20 | DIN 912 M3x20 | 2 | x | Hardware | M5x35 BHCS | ISO 7380-1 M5x35 | 4
Hardware | M3x25 | DIN 912 M3x25 | 2 | x | Hardware | M5x40 SHCS | DIN 912 M5x40 | 4
Hardware | M3x30 | DIN 912 M3x30 | 2 | x
Hardware | M3x30 | DIN 912 M3x30 | 4 | x
Hardware | M3x30 | DIN 912 M3x30 | 2 | x
Hardware | M3x35 | DIN 912 M3x35 | 4 | x
Hardware | M3x35 | DIN 912 M3x35 | 4 | x
Hardware | M3x40 | DIN 912 M3x40 | 4 | x
Hardware | M3x40 | DIN 912 M3x40 | 8 | x
Hardware | M3x50 | DIN 912 M3x50 | 4 | x
 | M3x8 |  | 4 | x
Hardware | M3x8 | DIN 912 M3x8 | 1 | x
Hardware | M4x8 | DIN 912 M4x8 | 4 | x
Hardware | M5 T-Nut | M5 T-Nut | 1 | x
Hardware | M5 T-Nut | M5 T-Nut | 9 | x
 | M5 T-Nut | M5 T-Nut | 8 | x
Hardware | M5x10 | ISO 7380-1 M5x10 | 7 | x
 | M5x10 | ISO 7380-1 M5x10 | 12 | x
Hardware | M5x15 | ISO 7380 M5x15 | 1 | x
Hardware | M5x16 | ISO 7380 M5x16 | 2 | x
Hardware | M5x20 | ISO 7380-1 M5x20 | 1 | x
Hardware | M5x35 | ISO 7380-1 V2 M5x35 | 2 | x
Hardware | M5x35 | ISO 7380-1 V2 M5x35 | 2 | x
Hardware | M5x40 | DIN 912 M5x40 | 2 | x
Hardware | M5x40 | DIN 912 M5x40 | 2 | x
