cuihuir/Tiny-M/BOM/嘉立创FA物料匹配模板.xlsx

说明： 1、标红字段“我的型号”和“商品数量”为必填项，且“商品数量”不能为0，否则可能导致导入失败； 2、“品牌”和“分类”建议尽量填写完整，这将有助于提高BOM匹配的准确性； 3、“是否国产替代”栏：如果您需要进口产品，请明确填写“否”；
序号 | *我的型号 | 我的商品名称 | JLC型号 （如有，则请填写） | *商品数量 | 是否国产替代 （填写:是/否） | 品牌 | 类别 | PO号
