cuihuir/Tiny-M/DXFs/heatbed-aluminum-plate-v1.1.DXF

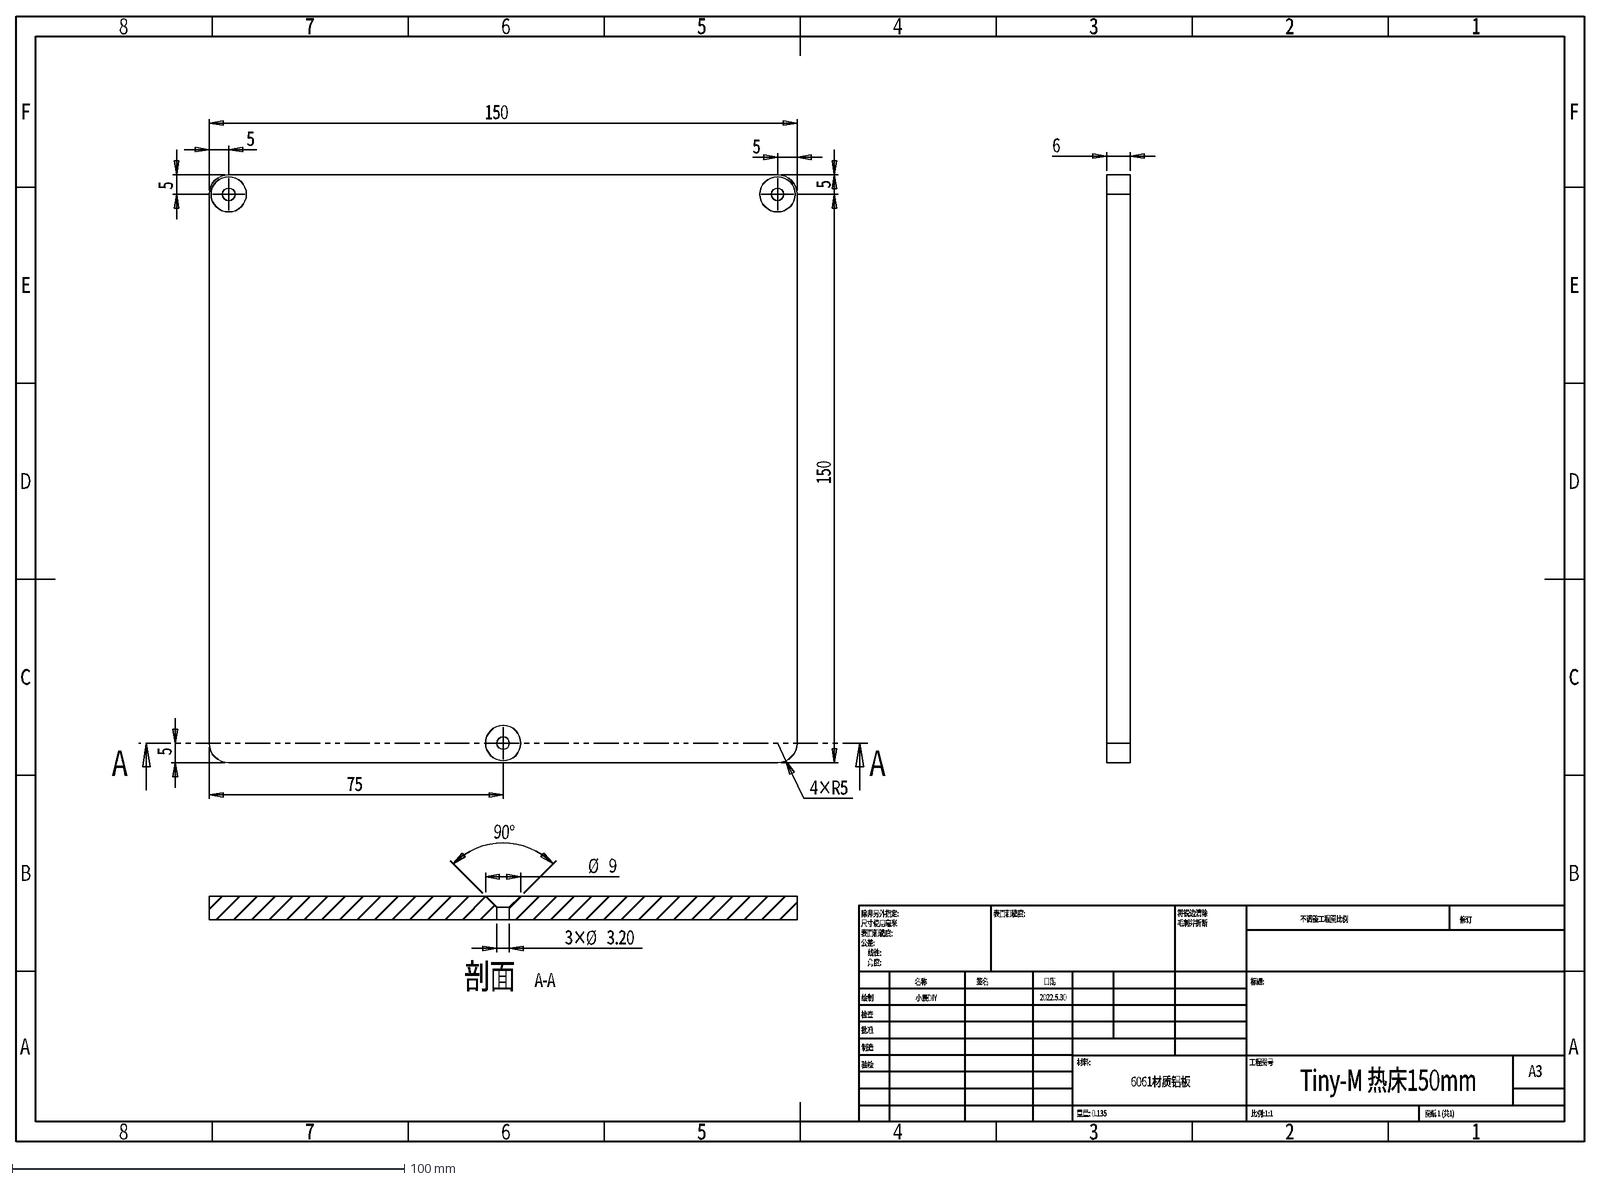
[picture p1: CAD file, 2026-04-29]
DXFs/heatbed-aluminum-plate-v1.1.DXF
A
B
C
D
E
F
8
7
6
5
4
3
2
1
绘制
检查
批准
制造
验检
除非另外指定:
尺寸使用毫米
表面粗糙度:
公差:
线性:
角度:
将锐边清除
毛刺并折断
名称
签名
日期
材料:
不调整工程图比例
修订
标题:
工程图号
比例:1:1
图纸 1 (共1)
A3
6061材质铝板
重量: 0.135
小辰DIY
2022.5.30
Tiny-M 热床150mm
150
75
4×
R5
90°
Ø
9
3×
3.20
剖面
A-A
