cuihuir/Tiny-M/STLs/rail-jigs/mgn12定位件.STL

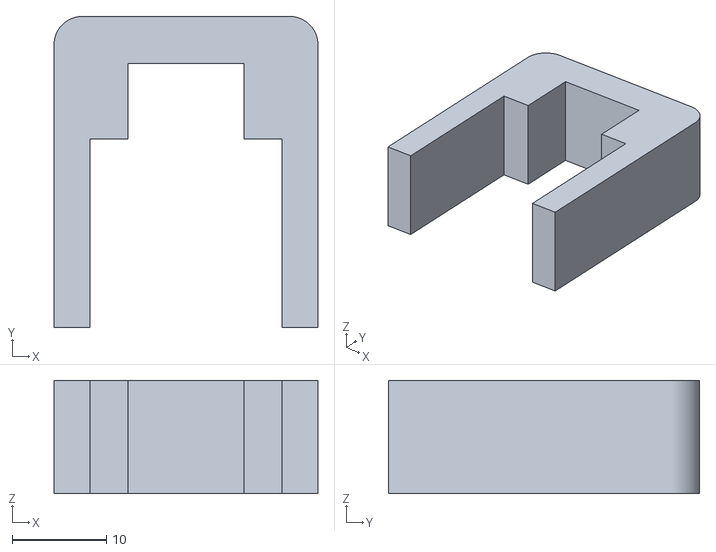
[picture p2: CAD file, 2026-04-29]
STLs/rail-jigs/mgn12定位件.STL
28.0 x 33.0 x 12.0
