cuihuir/Tiny-M/STLs/rail-jigs/导轨滑块防滑脱固定件.stl

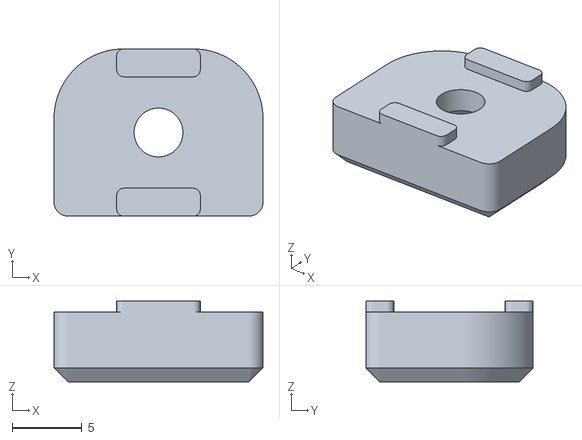
[picture p3: CAD file, 2026-04-29]
STLs/rail-jigs/导轨滑块防滑脱固定件.stl
15.0 x 12.0 x 5.80
