cuihuir/Tiny-M/STLs/rail-jigs/mgn9定位件.STL

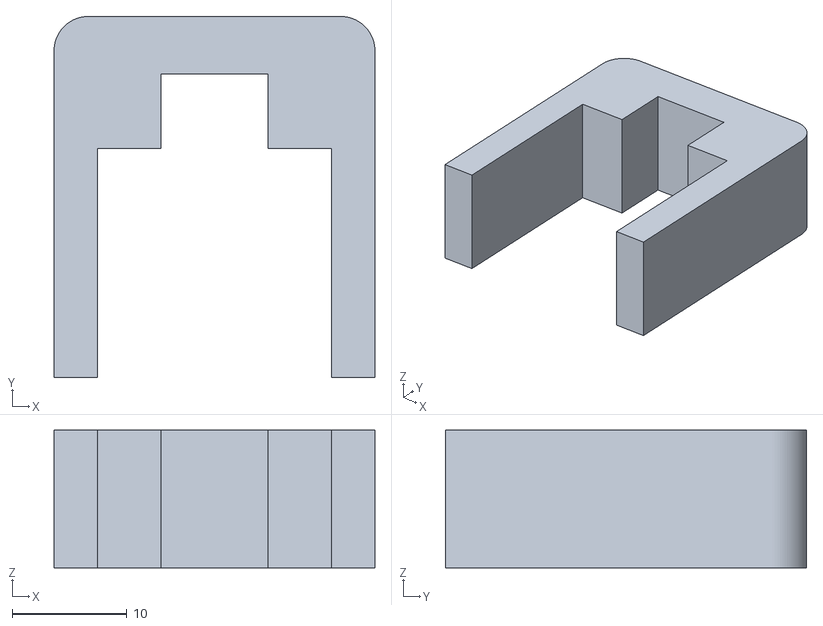
[picture p4: CAD file, 2026-04-29]
STLs/rail-jigs/mgn9定位件.STL
28.0 x 31.5 x 12.0
