cuihuir/Tiny-M/(commit log)

2026-04-21 docs: restructure project docs and add bilingual BOM
    - Rewrite README as English primary, add README_cn.md (Chinese)
    - Add project references (gsl12 original, XiaoChen DIY V2.2)
    - Convert original xlsx BOM to markdown (DRAFT-BOM-gsl12)
    - Convert XiaoChen DIY V2.2 BOM to markdown with full detail
    - Add our own active BOM.md / BOM_cn.md based on XiaoChen V2.2
    - Organize BOM directory: root for active docs, reference/ for sources
    Status: material preparation in progress (物料准备中)
    [DRAFT - BOM - Tiny M.xlsx]
2026-04-21 docs: add V4 printer image to README
2026-04-21 feat: add JLC frame BOM and extrusion reorder tool
    - Update BOM with JLC-orderable extrusion model numbers (19 pieces)
    - Add BOM-Frame-JLCFA.md/xlsx as 嘉立创 first order
    - Add 嘉立创FA物料匹配模板.xlsx as reference template
    - Add tools/jlc_reorder.py for reordering processing codes to JLC format
    - Update BOM readme with tool usage docs
    [BOM-Frame-JLCFA.xlsx, 嘉立创FA物料匹配模板.xlsx]
2026-04-29 feat: update BOM with rail carriage details and heatbed DXF
    - Add heatbed aluminum plate DXF (XiaoChen V1.1, with countersunk holes)
    - Add rail jig STLs (MGN12/MGN9 positioning, anti-drop brackets)
    - Note MGN12H must be extended version for E3D V6 hotend
    - Add processing description column to extrusion BOM table
    - Create CLAUDE.md for project context
    [heatbed-aluminum-plate-v1.1.DXF, mgn12定位件.STL, mgn9定位件.STL, 导轨滑块防滑脱固定件.stl]
